Teichmon/KiCAD_Modules/footprints/3D/DRV8834PWPR.stp

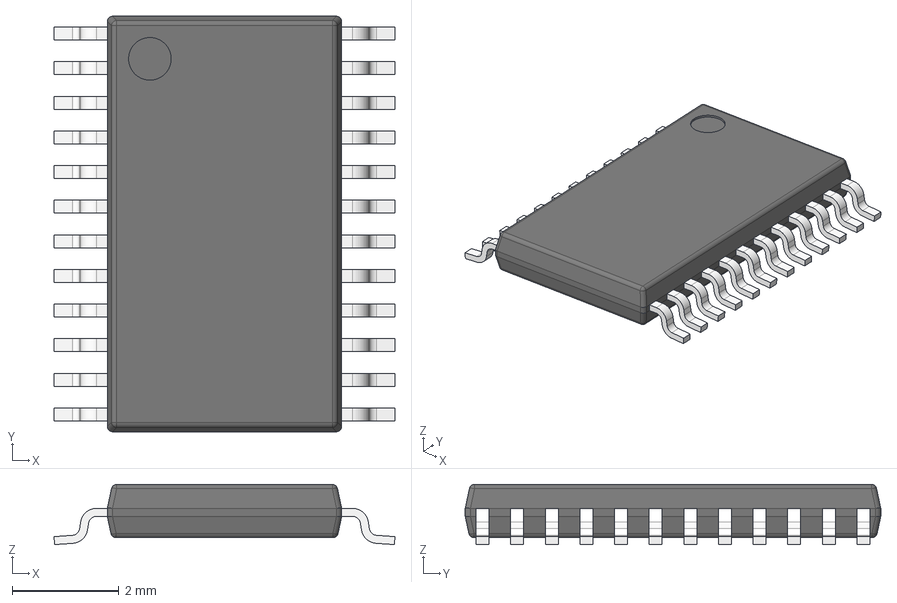
[picture p1: CAD file, 2024-11-25]
footprints/3D/DRV8834PWPR.stp
6.40 x 7.80 x 1.13 mm
BODY-TSSOP
LEAD-TSSOP x 24
DAP
