Teichmon/KiCAD_Modules/footprints/3D/338068-6.stp

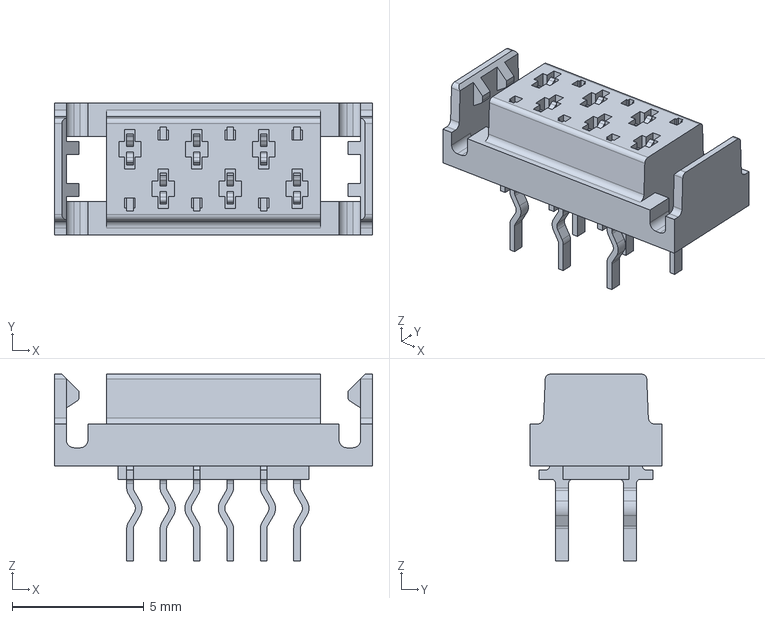
[picture p2: CAD file, 2024-11-25]
footprints/3D/338068-6.stp
12.1 x 5.00 x 7.10 mm
