Teichmon/KiCAD_Modules/footprints/3D/1757242.stp

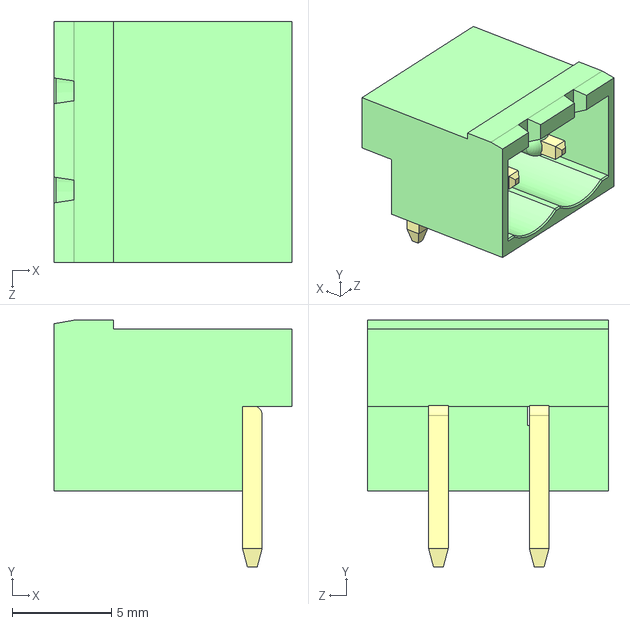
[picture p3: CAD file, 2024-11-25]
footprints/3D/1757242.stp
12.0 x 12.4 x 12.2 mm
