Teichmon/KiCAD_Modules/footprints/3D/690367180672.step

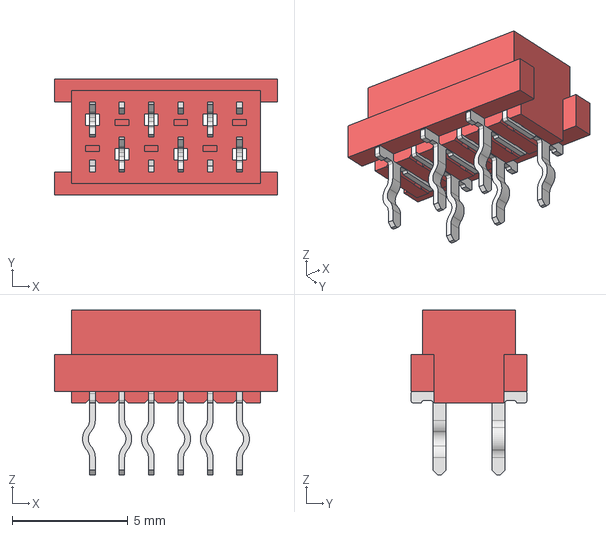
[picture p4: CAD file, 2024-11-25]
footprints/3D/690367180672.step
9.62 x 5.00 x 7.10 mm
Pin x 6
