Teichmon/KiCAD_Modules/footprints/3D/1962600.stp

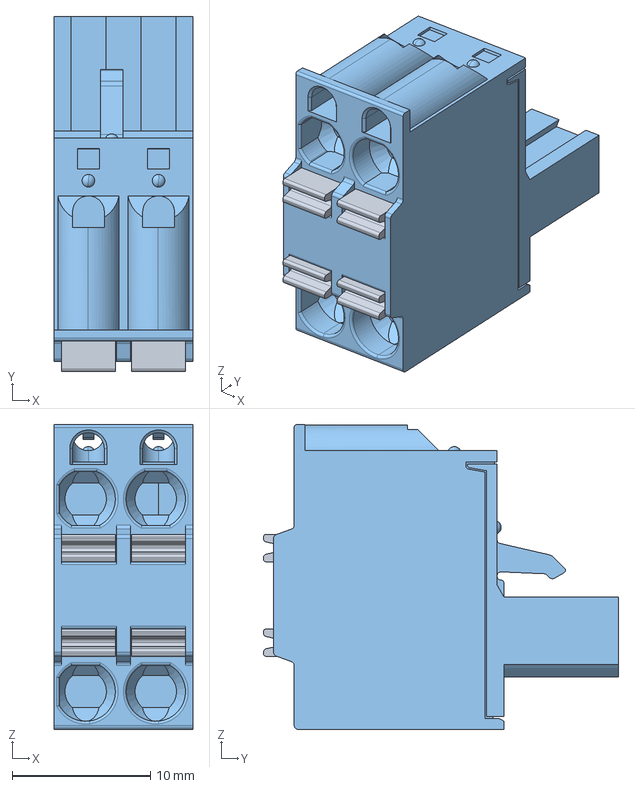
[picture p5: CAD file, 2024-11-25]
footprints/3D/1962600.stp
10.1 x 25.7 x 22.1 mm
